danielsaul/kraken/README.md

The Kraken
==========
Poseidon Ocean Drifter Project  
http://poseidon.sgsphysics.co.uk

Tracker
http://track.poseidon.sgsphysics.co.uk/

Various Authors
