danielsaul/kraken/pcb/board.png

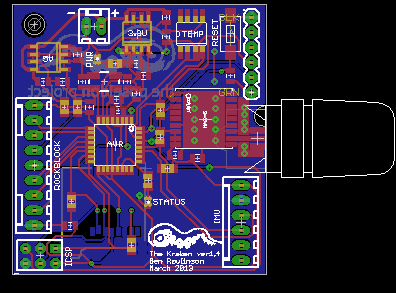
pcb/board.png
