danielsaul/kraken/pcb/schematic.png

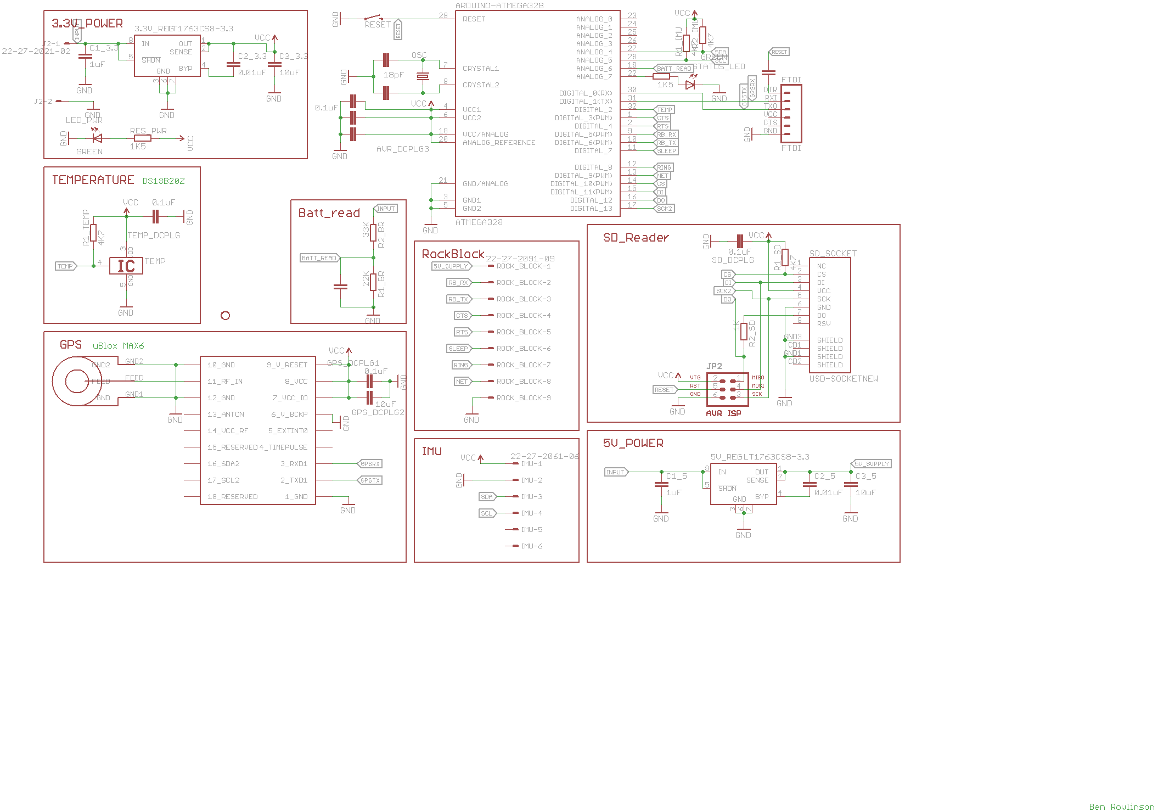
pcb/schematic.png
