danielsaul/kraken/pcb/kraken.brd

## EAGLE design pcb/kraken.brd (2013-03-23)

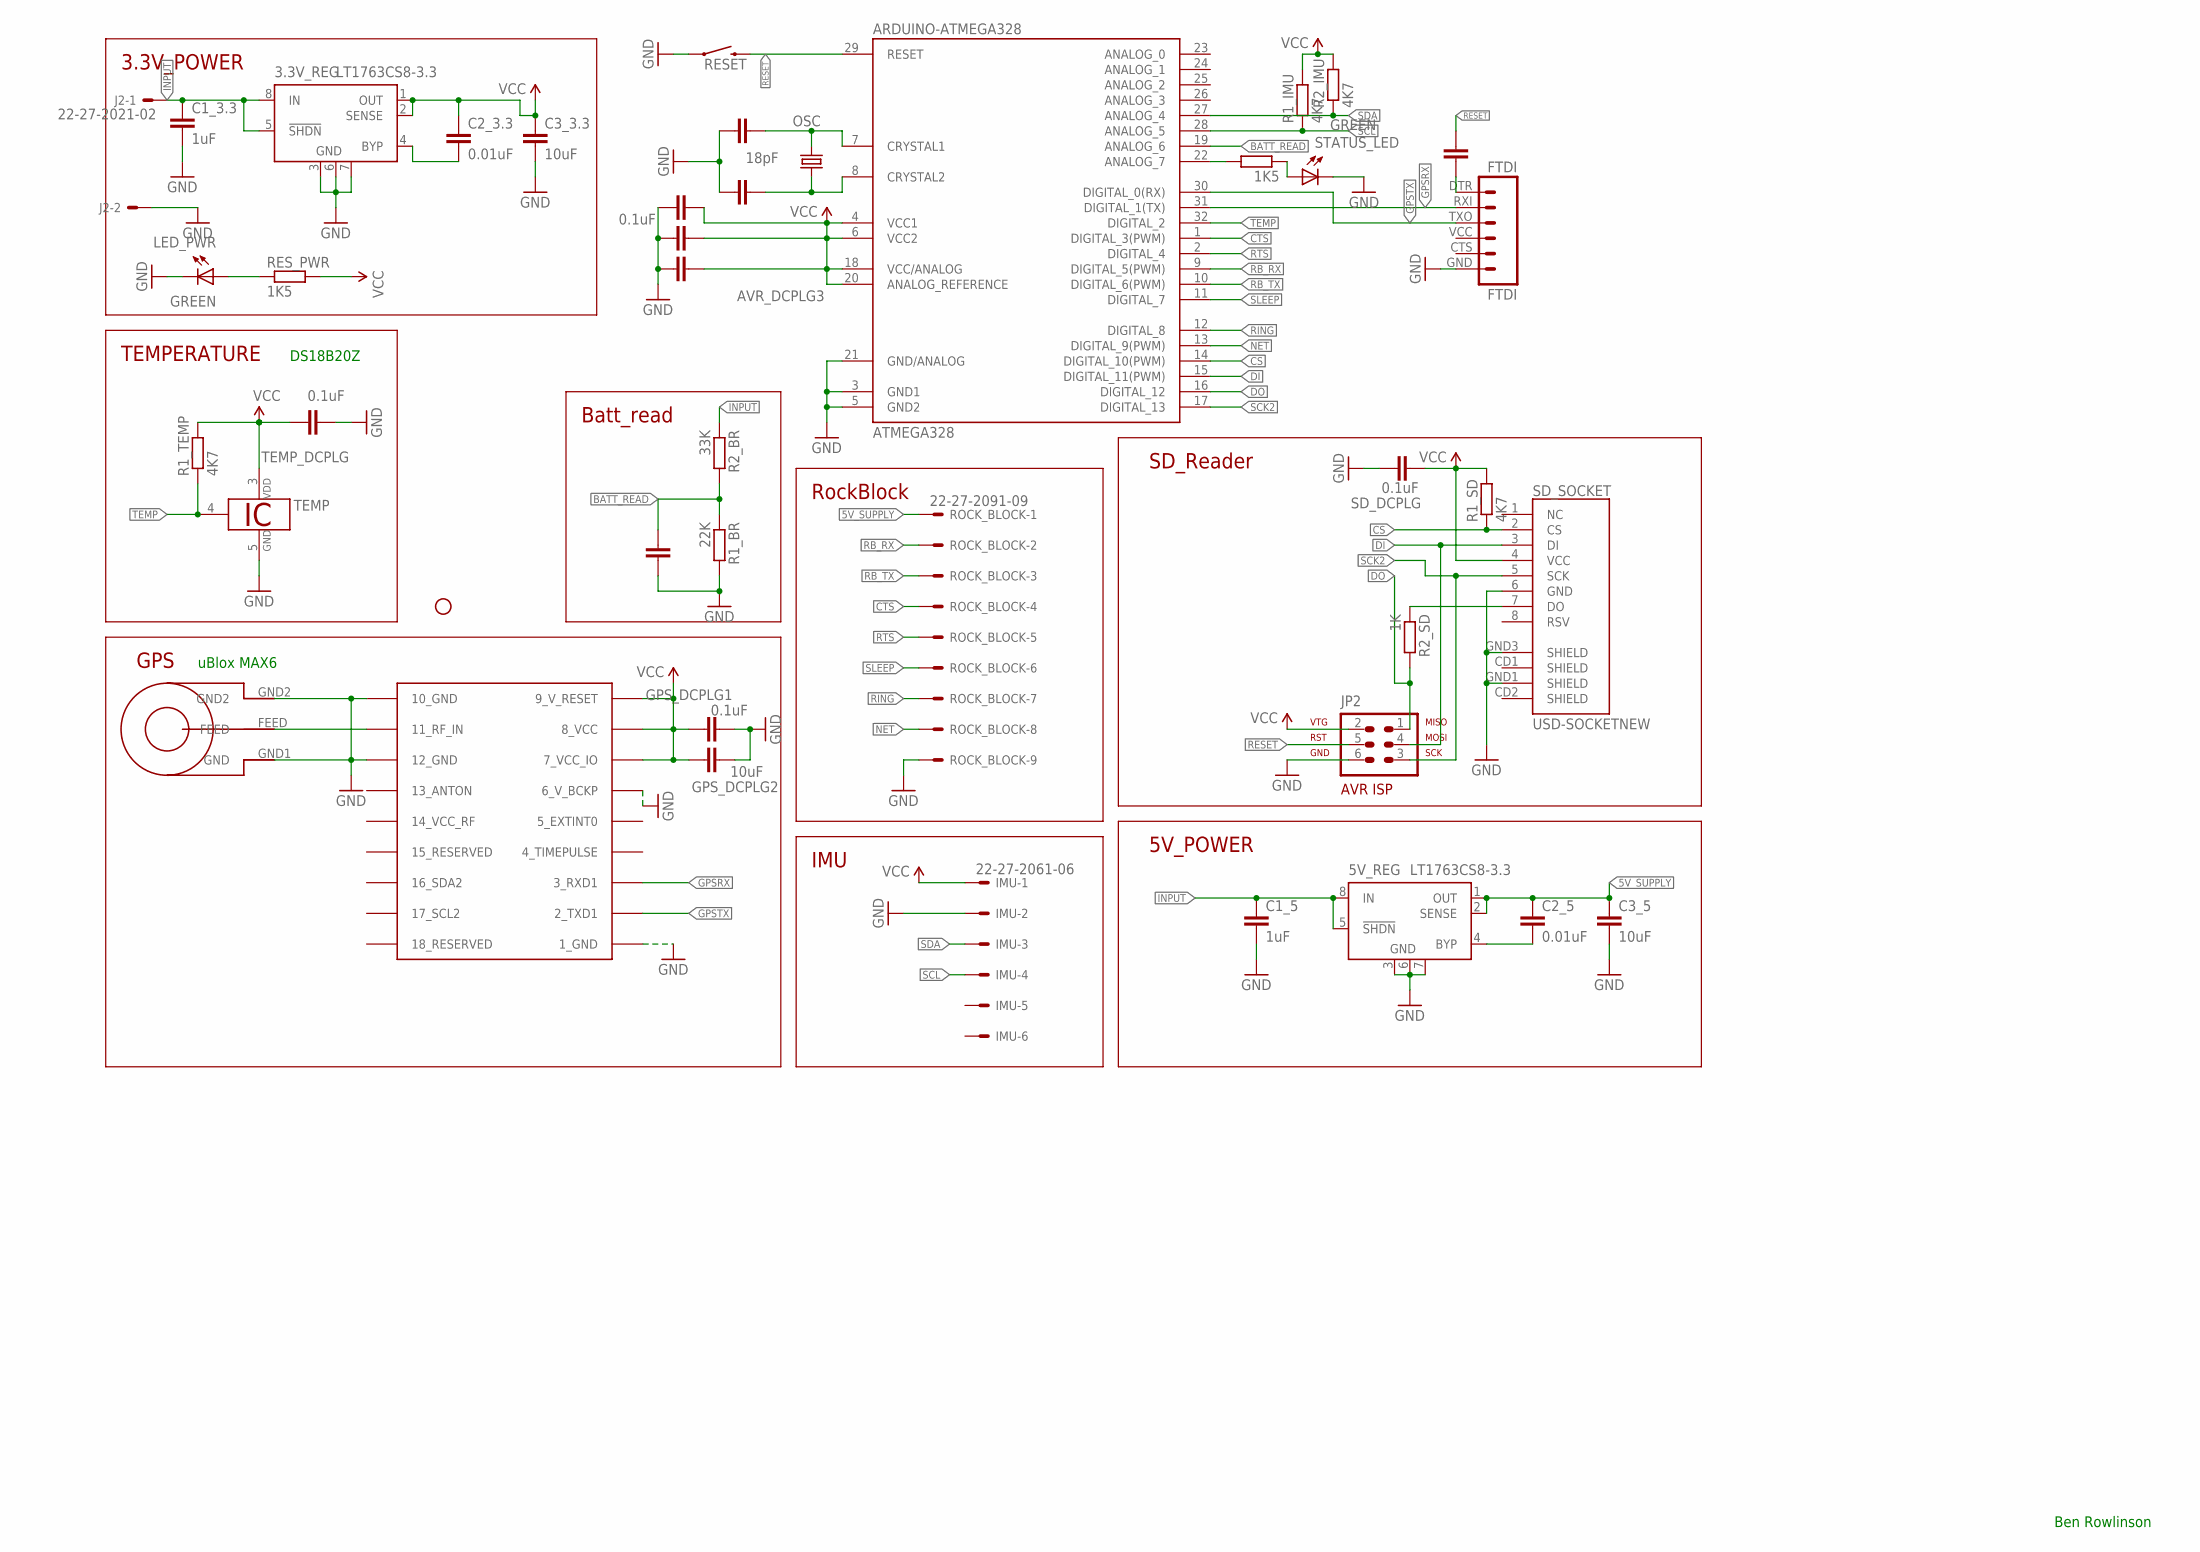
[picture p3: schematic kraken.sch]

Parts:
3.3V_REG, 5V_REG: LT1763CS8-3.3; SOIC8
ARDUINO-ATMEGA328: ATMEGA328; TQFP32-08
AVR_DCPLG1, AVR_DCPLG2, AVR_DCPLG3: 0.1uF; 0805
C1_3.3, C1_5: 1uF; 0805
C1_BR: 0.1uF; 0805
C1_OSC, C2_OSC: 18pF; 0805
C2_3.3, C2_5: 0.01uF; 0805
C3_3.3, C3_5: 10uF; 0805
FTDI: FTDI; FTDI_BASIC
FTDI_DCPLG: 0.1uF; 0805
GPS_DCPLG1: 0.1uF; 0805
GPS_DCPLG2: 10uF; 0805
IMU: 22-27-2061-06; 6410-06
J2: 22-27-2021-02; 6410-02
JP1: STAND-OFF
JP2: AVR-ISP-6
LED_PWR: GREEN; CHIPLED_0603
OSC: 16MHz; CRYSTAL-SMD-5X3
R1_BR: 22K; R0805
R1_IMU, R1_SD, R1_TEMP, R2_IMU: 4K7; R0805
R2_BR: 33K; R0805
R2_SD: 1K; R0805
RESET: SW-MOMENTARY-SMD; TACTILE-SWITCH-1101NE
RES_PWR: 1K5; R0805
ROCK_BLOCK: 22-27-2091-09; 6410-09
R_STATUS: 1K5; R0805
SD_DCPLG: 0.1uF; 0805
SD_SOCKET: USD-SOCKETNEW; MICRO-SD-SOCKET-PP
STATUS_LED: GREEN; CHIPLED_0603
TEMP: DS18B20Z; SO08
TEMP_DCPLG: 0.1uF; 0805
U$1: UBLOX_MAX-6
U$2: SARANTEL-SR1202

Connections:
5V_SUPPLY: 5V_REG.1 (OUT), 5V_REG.2 (SENSE), C2_5.1, C3_5.1, ROCK_BLOCK.1
BATT_READ: ARDUINO-ATMEGA328.19 (ANALOG_6), C1_BR.2, R1_BR.1, R2_BR.2
CS: ARDUINO-ATMEGA328.14 (DIGITAL_10(PWM)), R1_SD.1, SD_SOCKET.2 (CS)
CTS: ARDUINO-ATMEGA328.1 (DIGITAL_3(PWM)), ROCK_BLOCK.4
DI: ARDUINO-ATMEGA328.15 (DIGITAL_11(PWM)), JP2.4, SD_SOCKET.3 (DI)
DO: ARDUINO-ATMEGA328.16 (DIGITAL_12), JP2.1, R2_SD.2
GND: 3.3V_REG.3 (GND), 3.3V_REG.6 (GND), 3.3V_REG.7 (GND), 5V_REG.3 (GND), 5V_REG.6 (GND), 5V_REG.7 (GND), ARDUINO-ATMEGA328.3 (GND1), ARDUINO-ATMEGA328.5 (GND2), ARDUINO-ATMEGA328.21 (GND/ANALOG), AVR_DCPLG1.1, AVR_DCPLG2.1, AVR_DCPLG3.1, C1_3.3.2, C1_5.2, C1_BR.1, C1_OSC.1, C2_OSC.1, C3_3.3.2, C3_5.2, FTDI.GND (6), GPS_DCPLG1.2, GPS_DCPLG2.2, IMU.2, J2.2, JP2.6, LED_PWR.C, R1_BR.2, RESET.P$1 (1), ROCK_BLOCK.9, SD_DCPLG.2, SD_SOCKET.6 (GND), SD_SOCKET.GND1 (SHIELD), SD_SOCKET.GND3 (SHIELD), STATUS_LED.C, TEMP.5 (GND), TEMP_DCPLG.1, U$1.1_GND, U$1.6_V_BCKP, U$1.10_GND, U$1.12_GND, U$2.GND1 (GND), U$2.GND2
GPSRX: ARDUINO-ATMEGA328.31 (DIGITAL_1(TX)), FTDI.RXI (2), U$1.3_RXD1
GPSTX: ARDUINO-ATMEGA328.30 (DIGITAL_0(RX)), FTDI.TXO (3), U$1.2_TXD1
INPUT: 3.3V_REG.5 (!SHDN), 3.3V_REG.8 (IN), 5V_REG.5 (!SHDN), 5V_REG.8 (IN), C1_3.3.1, C1_5.1, J2.1, R2_BR.1
unnamed: R_STATUS.1, STATUS_LED.A
unnamed: R2_SD.1, SD_SOCKET.7 (DO)
unnamed: LED_PWR.A, RES_PWR.1
unnamed: ARDUINO-ATMEGA328.22 (ANALOG_7), R_STATUS.2
unnamed: ARDUINO-ATMEGA328.8 (CRYSTAL2), C2_OSC.2, OSC.1
unnamed: ARDUINO-ATMEGA328.7 (CRYSTAL1), C1_OSC.2, OSC.3 (2)
unnamed: 3.3V_REG.4 (BYP), C2_3.3.2
unnamed: U$1.11_RF_IN, U$2.FEED
unnamed: 5V_REG.4 (BYP), C2_5.2
unnamed: FTDI.DTR (1), FTDI_DCPLG.2
NET: ARDUINO-ATMEGA328.13 (DIGITAL_9(PWM)), ROCK_BLOCK.8
RB_RX: ARDUINO-ATMEGA328.9 (DIGITAL_5(PWM)), ROCK_BLOCK.2
RB_TX: ARDUINO-ATMEGA328.10 (DIGITAL_6(PWM)), ROCK_BLOCK.3
RESET: ARDUINO-ATMEGA328.29 (RESET), FTDI_DCPLG.1, JP2.5, RESET.P$2 (2)
RING: ARDUINO-ATMEGA328.12 (DIGITAL_8), ROCK_BLOCK.7
RTS: ARDUINO-ATMEGA328.2 (DIGITAL_4), ROCK_BLOCK.5
SCK2: ARDUINO-ATMEGA328.17 (DIGITAL_13), JP2.3, SD_SOCKET.5 (SCK)
SCL: ARDUINO-ATMEGA328.28 (ANALOG_5), IMU.4, R1_IMU.1
SDA: ARDUINO-ATMEGA328.27 (ANALOG_4), IMU.3, R2_IMU.1
SLEEP: ARDUINO-ATMEGA328.11 (DIGITAL_7), ROCK_BLOCK.6
TEMP: ARDUINO-ATMEGA328.32 (DIGITAL_2), R1_TEMP.1, TEMP.4 (1W)
VCC: 3.3V_REG.1 (OUT), 3.3V_REG.2 (SENSE), ARDUINO-ATMEGA328.4 (VCC1), ARDUINO-ATMEGA328.6 (VCC2), ARDUINO-ATMEGA328.18 (VCC/ANALOG), ARDUINO-ATMEGA328.20 (ANALOG_REFERENCE), AVR_DCPLG1.2, AVR_DCPLG2.2, AVR_DCPLG3.2, C2_3.3.1, C3_3.3.1, GPS_DCPLG1.1, GPS_DCPLG2.1, IMU.1, JP2.2, R1_IMU.2, R1_SD.2, R1_TEMP.2, R2_IMU.2, RES_PWR.2, SD_DCPLG.1, SD_SOCKET.4 (VCC), TEMP.3 (VDD), TEMP_DCPLG.2, U$1.7_VCC_IO, U$1.8_VCC, U$1.9_V_RESET

Notes on the sheet:
3.3V_POWER
TEMPERATURE
Ben Rowlinson
GPS
uBlox MAX6
DS18B20Z
RockBlock
IMU
5V_POWER
SD_Reader
Batt_read

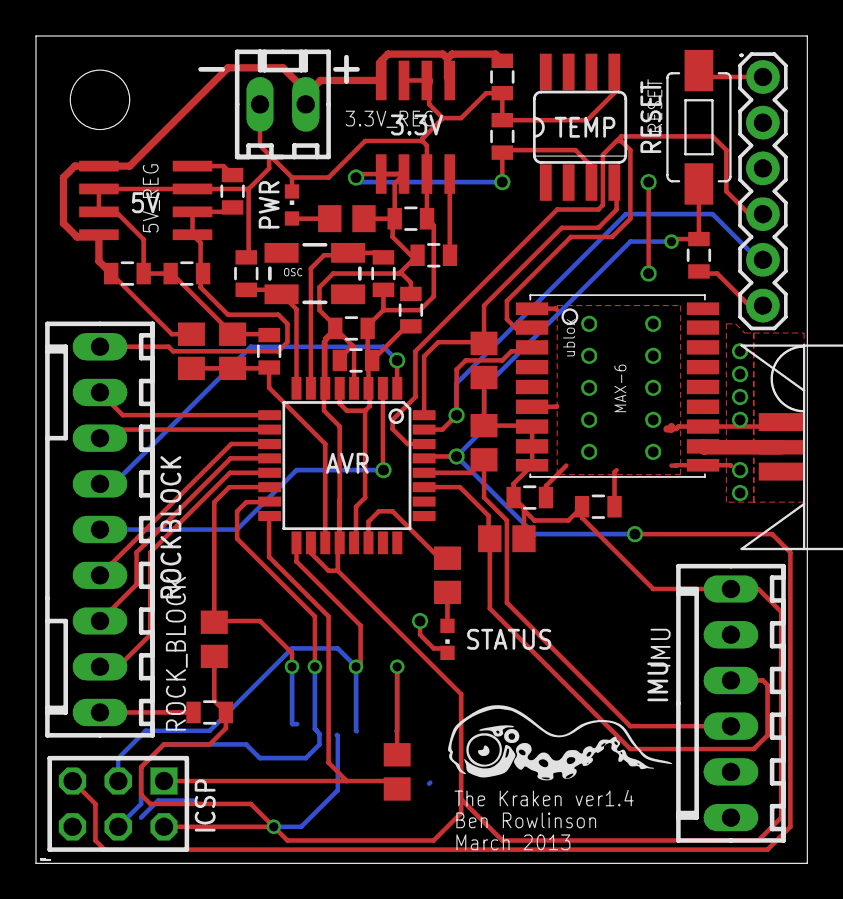
[picture p4: board kraken.brd from above]

Board: 2 copper layers, 42.8 x 46.0 mm, 43 parts (1 on the bottom side), 32 nets.
