danielsaul/kraken/(commit log)

2013-03-23 Added schematic and pcb
    [kraken.brd, kraken.sch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]
2013-03-27 only goes into power save if has lock
2013-03-27 only goes into power save if has lock - fixed for seamode
    [kraken.ino]
2013-03-28 Added and edited files from Apex. Temperature, Counter, Battery etc.
2013-03-30 tidy code, collect GPS, temp, battery data, send via iridium
2013-03-30 added IMU code
2013-03-30 changed sample rate
2013-03-30 sample rate
2013-03-30 cut down ram usage, change sample rate
2013-03-31 put imu into sleep mode
2013-03-31 power saving and fixing rockblock bugs
    [RockBlock.cpp, kraken.ino]
2013-03-31 imu data in every nth transmission
2013-04-01 sleep for shorter time if unsuccessful
    [kraken.ino]
2013-04-21 Revert "turn debug off"
    This reverts commit e652ed92ef84c52d558841d1414abc6c91c7aa60.
    [debug.h]
2013-04-21 added constant to enable/disable IMU
2013-04-21 turn imu off
2013-04-21 Added Kraken2 temp sensor address
2013-04-24 Added functions to get and set IMU en/freq
2013-04-24 Finished commands and added new IMU functions to main loop
2013-04-24 Don't need to print SBDIX values anymore
2013-04-24 Print cmd in hex
2013-04-24 Revert "Disabled debug"
    This reverts commit 643f59a989e43e57b380894fabff0e6293d8c796.
    [debug.h]
2013-04-24 Revert "Revert "Disabled debug""
    This reverts commit 68d29e2552030a870280bd71b937b1fe62507712.
    [debug.h]
